HeyPCB/knuckle/cad/exploded.png

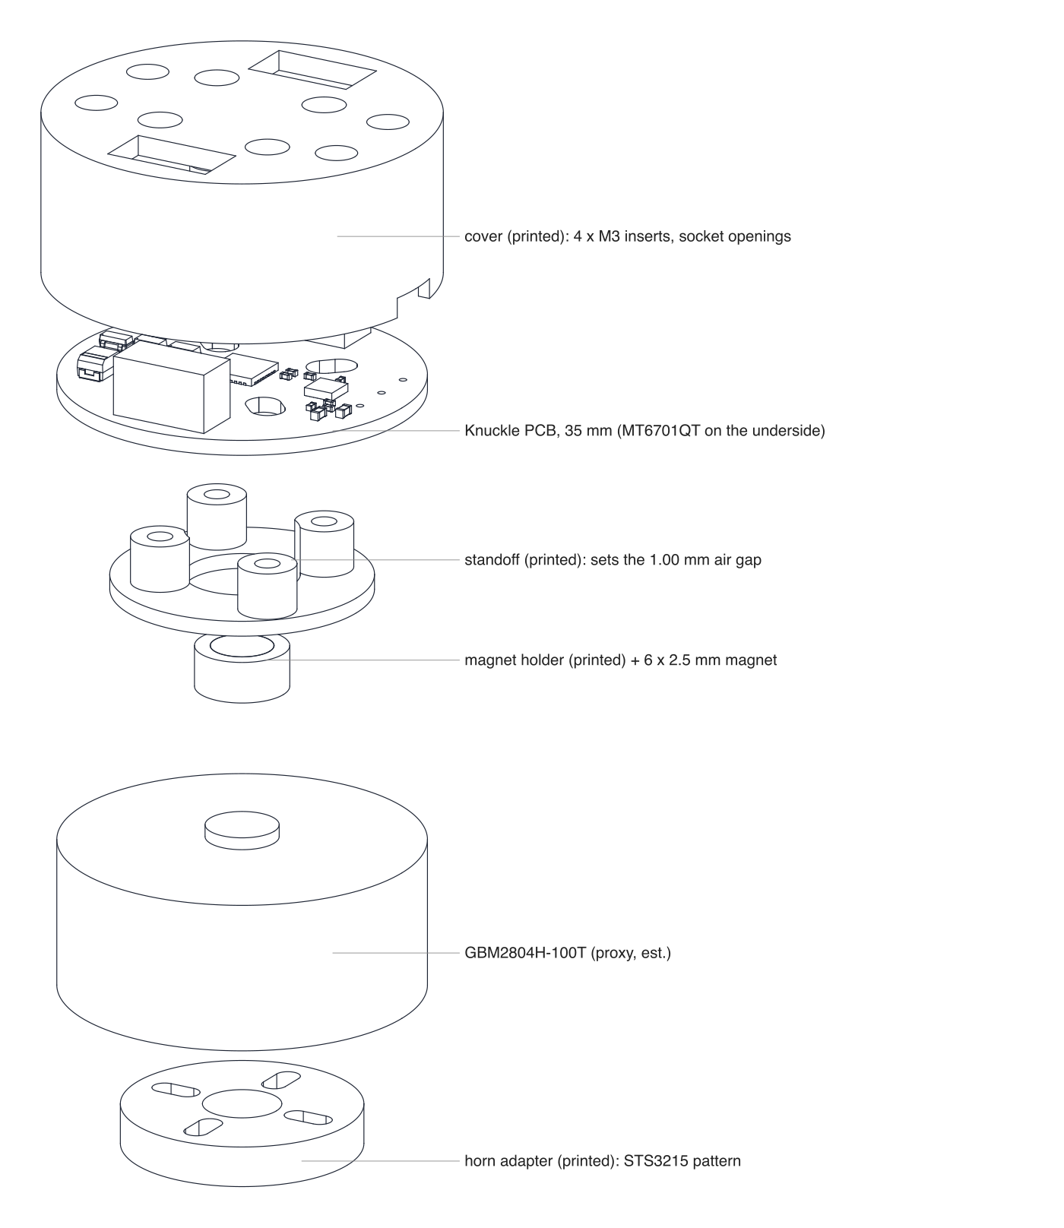
cad/exploded.png
