HeyPCB/knuckle/cad/section.png

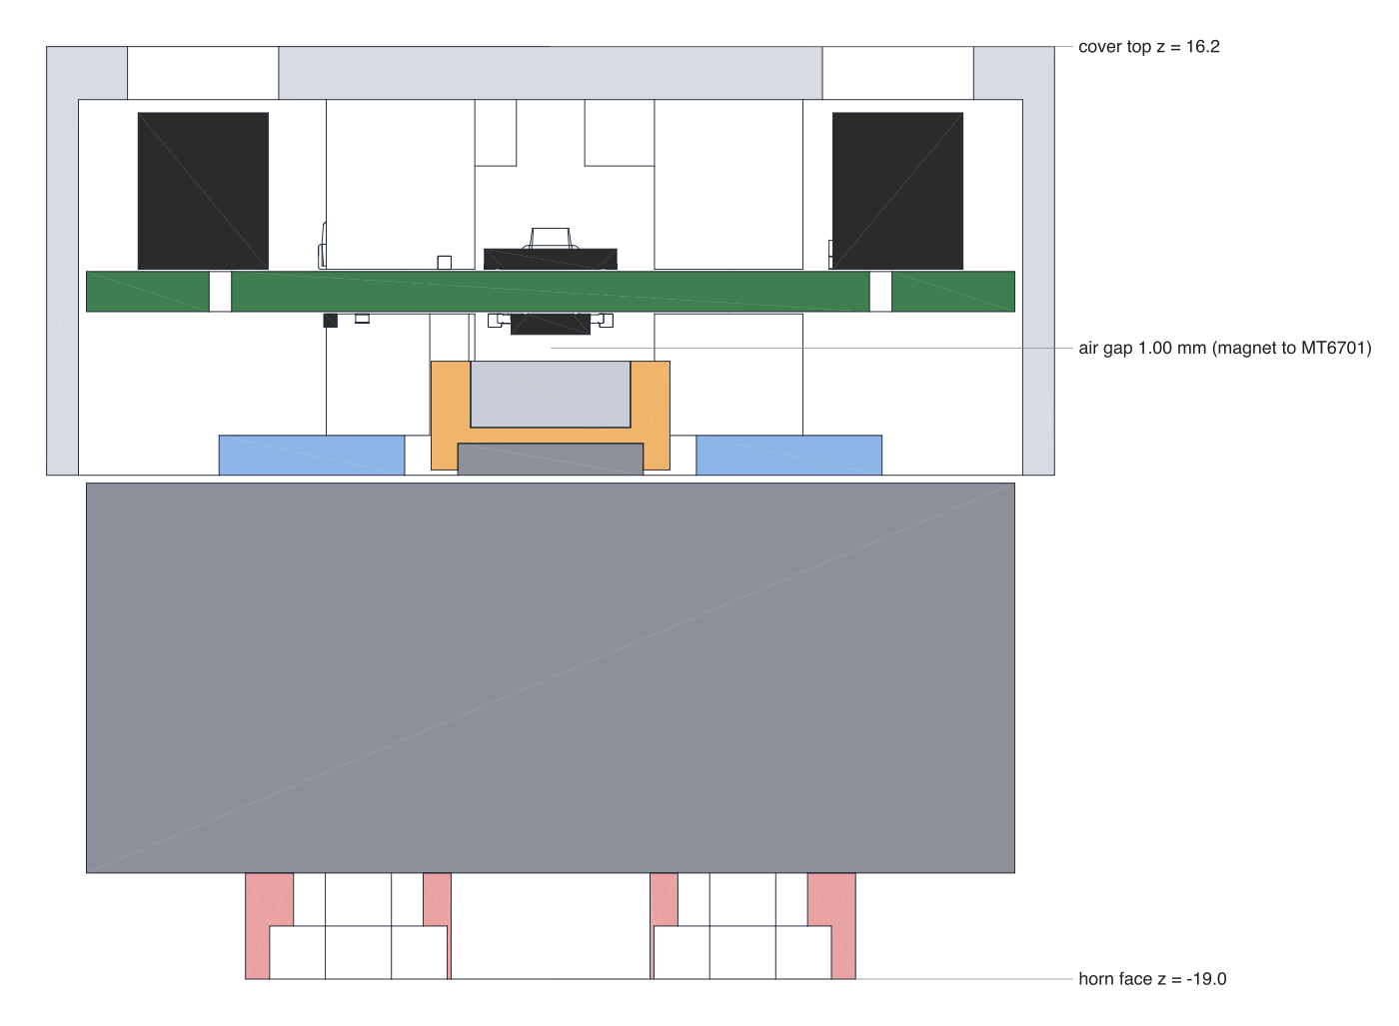
cad/section.png
