HeyPCB/knuckle/media/bottom.png

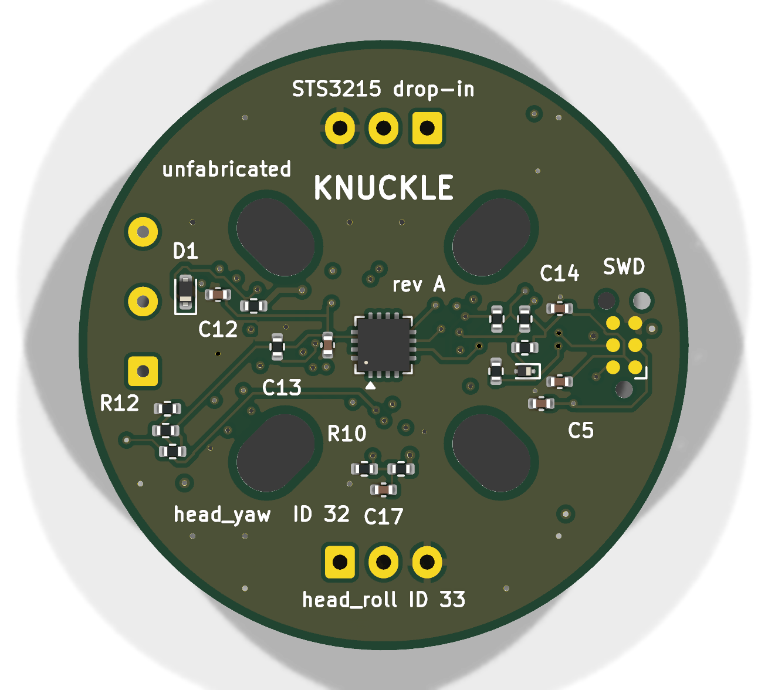
media/bottom.png
