HeyPCB/knuckle/media/top.png

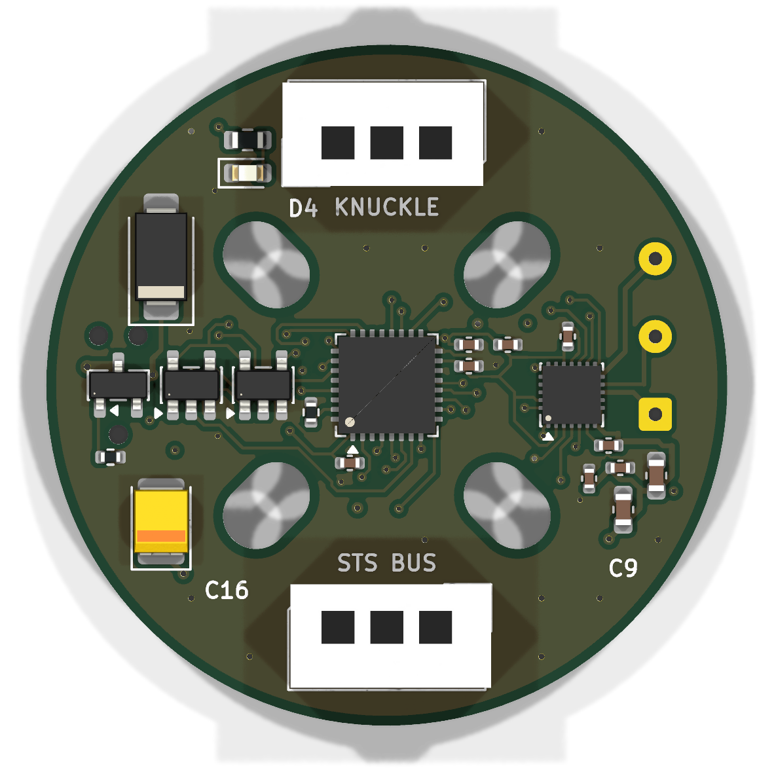
media/top.png
