HeyPCB/knuckle/fab/knuckle_bom.csv

Reference | Value | Footprint | MPN | LCSC | Qty
C1,C2,C3,C5,C10,C12,C13,C14,C15,C17 | 100nF | Capacitor_SMD:C_0402_1005Metric | CL05B104KO5NNNC | C1525 | 10
C4 | 1uF | Capacitor_SMD:C_0402_1005Metric | CL05A105KA5NQNC | C52923 | 1
C6,C8 | 100nF 50V | Capacitor_SMD:C_0402_1005Metric | CL05B104KB54PNC | C307331 | 2
C7,C9 | 10uF 25V | Capacitor_SMD:C_0603_1608Metric | CL10A106MA8NRNC | C96446 | 2
C11 | 2.2uF | Capacitor_SMD:C_0402_1005Metric | CL05A225MQ5NSNC | C12530 | 1
C16 | 22uF 25V polymer | Capacitor_Tantalum_SMD:CP_EIA-3528-21_Kemet-B | T521B226M025ATE100 | C696813 | 1
D1 | 5.1V | Diode_SMD:D_SOD-523 | MM5Z5V1T1G | C146754 | 1
D2 | ESD 5V | Diode_SMD:D_SOD-923 | TPESD9B5.0ST5G | C2682268 | 1
D3 | SMAJ12A | Diode_SMD:D_SMA | SMAJ12A | C113957 | 1
D4 | Red (STAT) | LED_SMD:LED_0603_1608Metric | KT-0603R | C2286 | 1
J1,J2 | 5267-03A | Connector_Molex:Molex_SPOX_5267-03A_1x03_P2.50mm_Vertical | 0022035035 | C45581067 | 2
Q1 | AO3401A | Package_TO_SOT_SMD:SOT-23 | AO3401A | C15127 | 1
R1,R6,R7,R9,R12 | 10k | Resistor_SMD:R_0402_1005Metric | 0402WGF1002TCE | C25744 | 5
R2,R4,R8,R10 | 100k | Resistor_SMD:R_0402_1005Metric | 0402WGF1003TCE | C25741 | 4
R3 | 5.1k | Resistor_SMD:R_0402_1005Metric | 0402WGF5101TCE | C25905 | 1
R5 | 100 | Resistor_SMD:R_0402_1005Metric | 0402WGF1000TCE | C25076 | 1
R11 | 22k | Resistor_SMD:R_0402_1005Metric | 0402WGF2202TCE | C25768 | 1
R13 | 1k | Resistor_SMD:R_0603_1608Metric | 0603WAF1001T5E | C21190 | 1
TH1 | 10k B3380 | Resistor_SMD:R_0402_1005Metric | NCP15XH103F03RC | C77131 | 1
U1 | STM32G431KBU6 | Package_DFN_QFN:QFN-32-1EP_5x5mm_P0.5mm_EP3.45x3.45mm | STM32G431KBU6 | C529358 | 1
U2 | DRV8311H | Package_DFN_QFN:Texas_RRW0024A_WQFN-24-1EP_3x3mm_P0.4mm_EP1.9x1.9mm | DRV8311HRRWR | C5218862 | 1
U3 | MT6701QT | Package_DFN_QFN:QFN-16-1EP_3x3mm_P0.5mm_EP1.7x1.7mm | MT6701QT-STD | C2913974 | 1
U4 | 74LVC1G126 | Package_TO_SOT_SMD:SOT-23-5 | SN74LVC1G126DBVR | C7834 | 1
U5 | 74LVC1G125 | Package_TO_SOT_SMD:SOT-23-5 | SN74LVC1G125DBVR | C23654 | 1
