HeyPCB/knuckle/cad/assembly.step

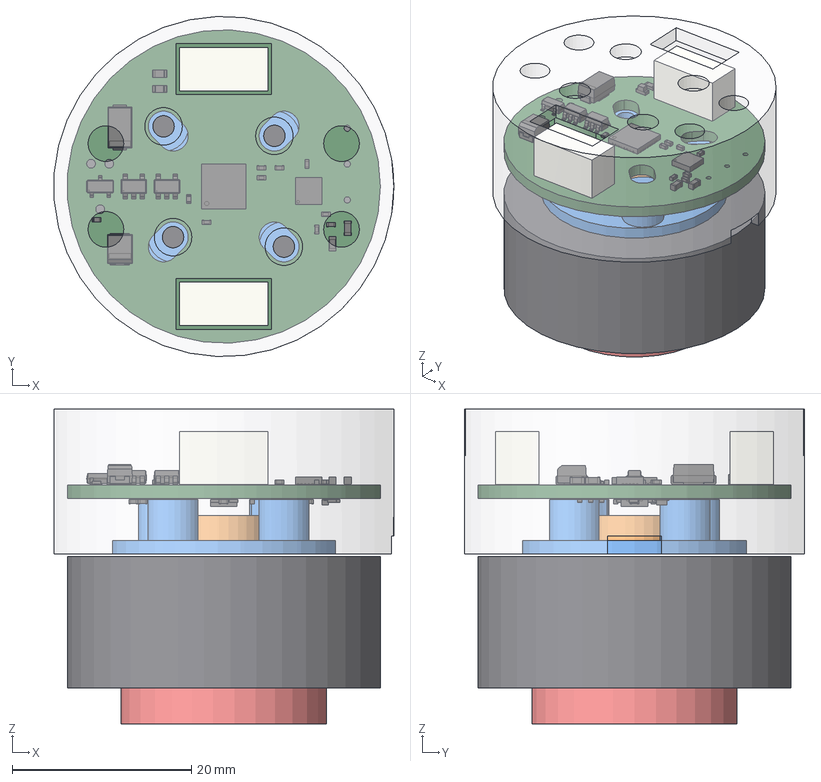
[picture p7: CAD file, 2026-10-03]
cad/assembly.step
37.9 x 38.0 x 35.2 mm
motor_proxy_est
magnet_holder
magnet
standoff
pcb
D3
D4
U5
R1
Q1
U2
R9
C11
C4
C16
C6
C1
C9
U1
C2
C10
R13
C8
U4
C3
C7
C5
R2
R10
D1
R3
R12
C12
C15
D2
R5
R4
C14
C13
R7
R6
R8
U3
C17
TH1
R11
J2_envelope
J1_envelope
cover
horn_adapter
