HeyPCB/knuckle/cad/magnet_holder.step

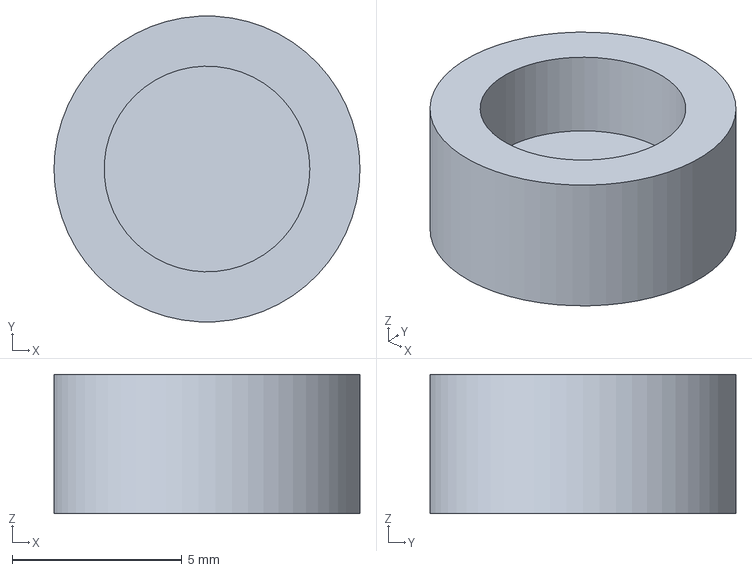
[picture p8: CAD file, 2026-10-03]
cad/magnet_holder.step
9.00 x 8.99 x 4.10 mm
