HeyPCB/knuckle/fab/knuckle.step

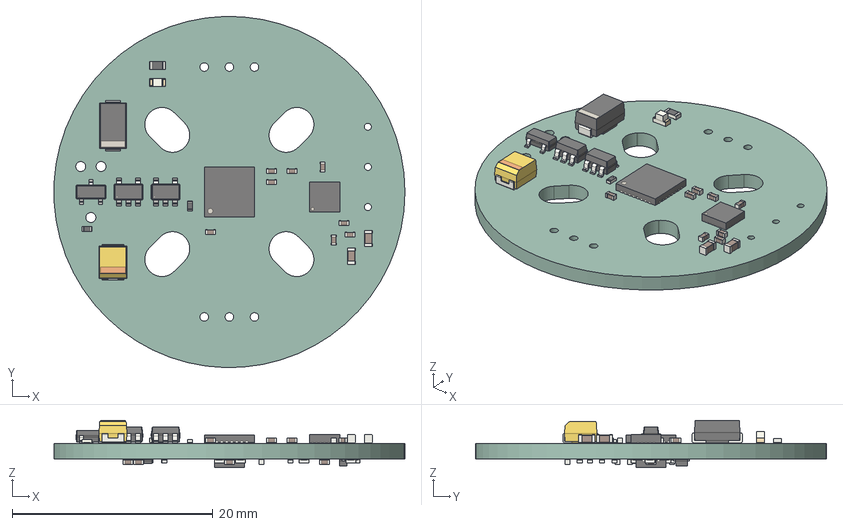
[picture p9: CAD file, 2026-10-03]
fab/knuckle.step
35.0 x 35.0 x 4.69 mm
D_SMA
LED_0603_1608Metric
SOT-23-5 x 2
R_0402_1005Metric x 13
SOT-23
Texas_RRW0024A_WQFN-24-1EP_3x3mm_P0.4mm_EP1.9x1.9mm
C_0402_1005Metric x 14
CP_EIA_3528_21_Kemet_B
C_0603_1608Metric x 2
QFN-32-1EP_5x5mm_Pitch0.5mm
R_0603_1608Metric
D_SOD_523
D_SOD_923
QFN-16-1EP_3x3mm_P0.5mm_EP1.7x1.7mm
knuckle_PCB
