HeyPCB/knuckle/cad/cover.step

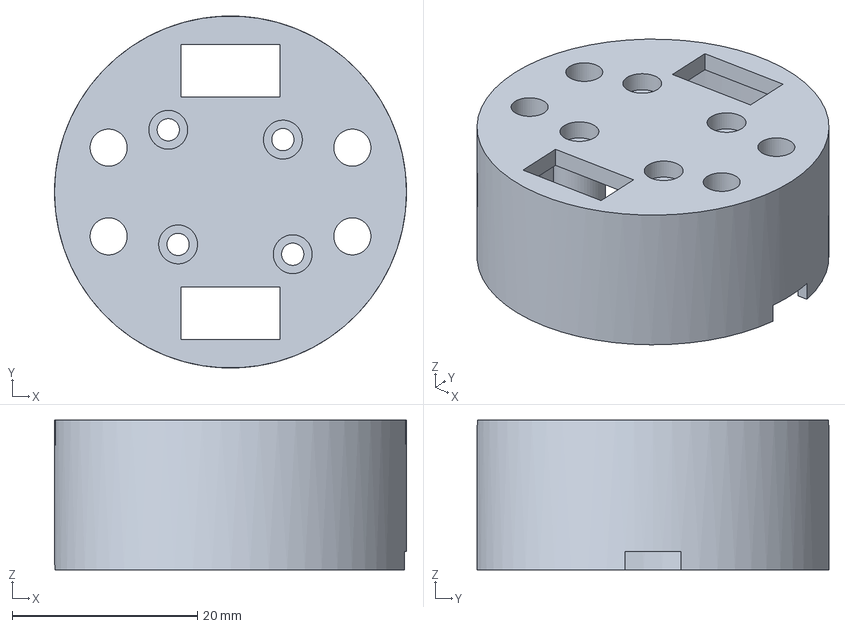
[picture p10: CAD file, 2026-10-03]
cad/cover.step
38.0 x 38.0 x 16.2 mm
