HeyPCB/knuckle/cad/standoff.step

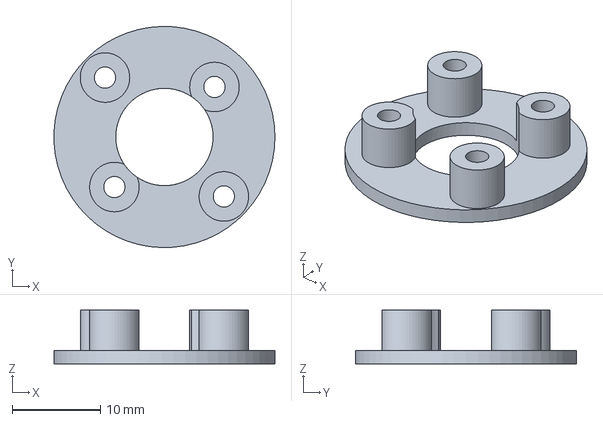
[picture p11: CAD file, 2026-10-03]
cad/standoff.step
25.0 x 25.0 x 6.09 mm
