HeyPCB/knuckle/cad/horn_adapter.step

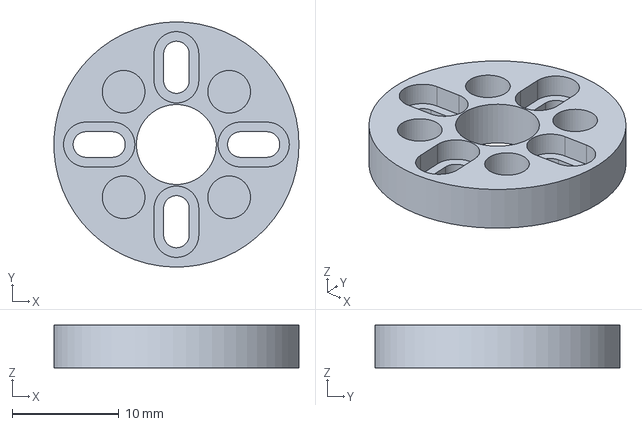
[picture p12: CAD file, 2026-10-03]
cad/horn_adapter.step
23.0 x 23.0 x 4.00 mm
