HeyPCB/knuckle/(list of files, cad)

Other CAD files:
cad/cover.stl
cad/horn_adapter.stl
cad/magnet_holder.stl
cad/standoff.stl
