HeyPCB/knuckle/fab/knuckle_schematic.pdf

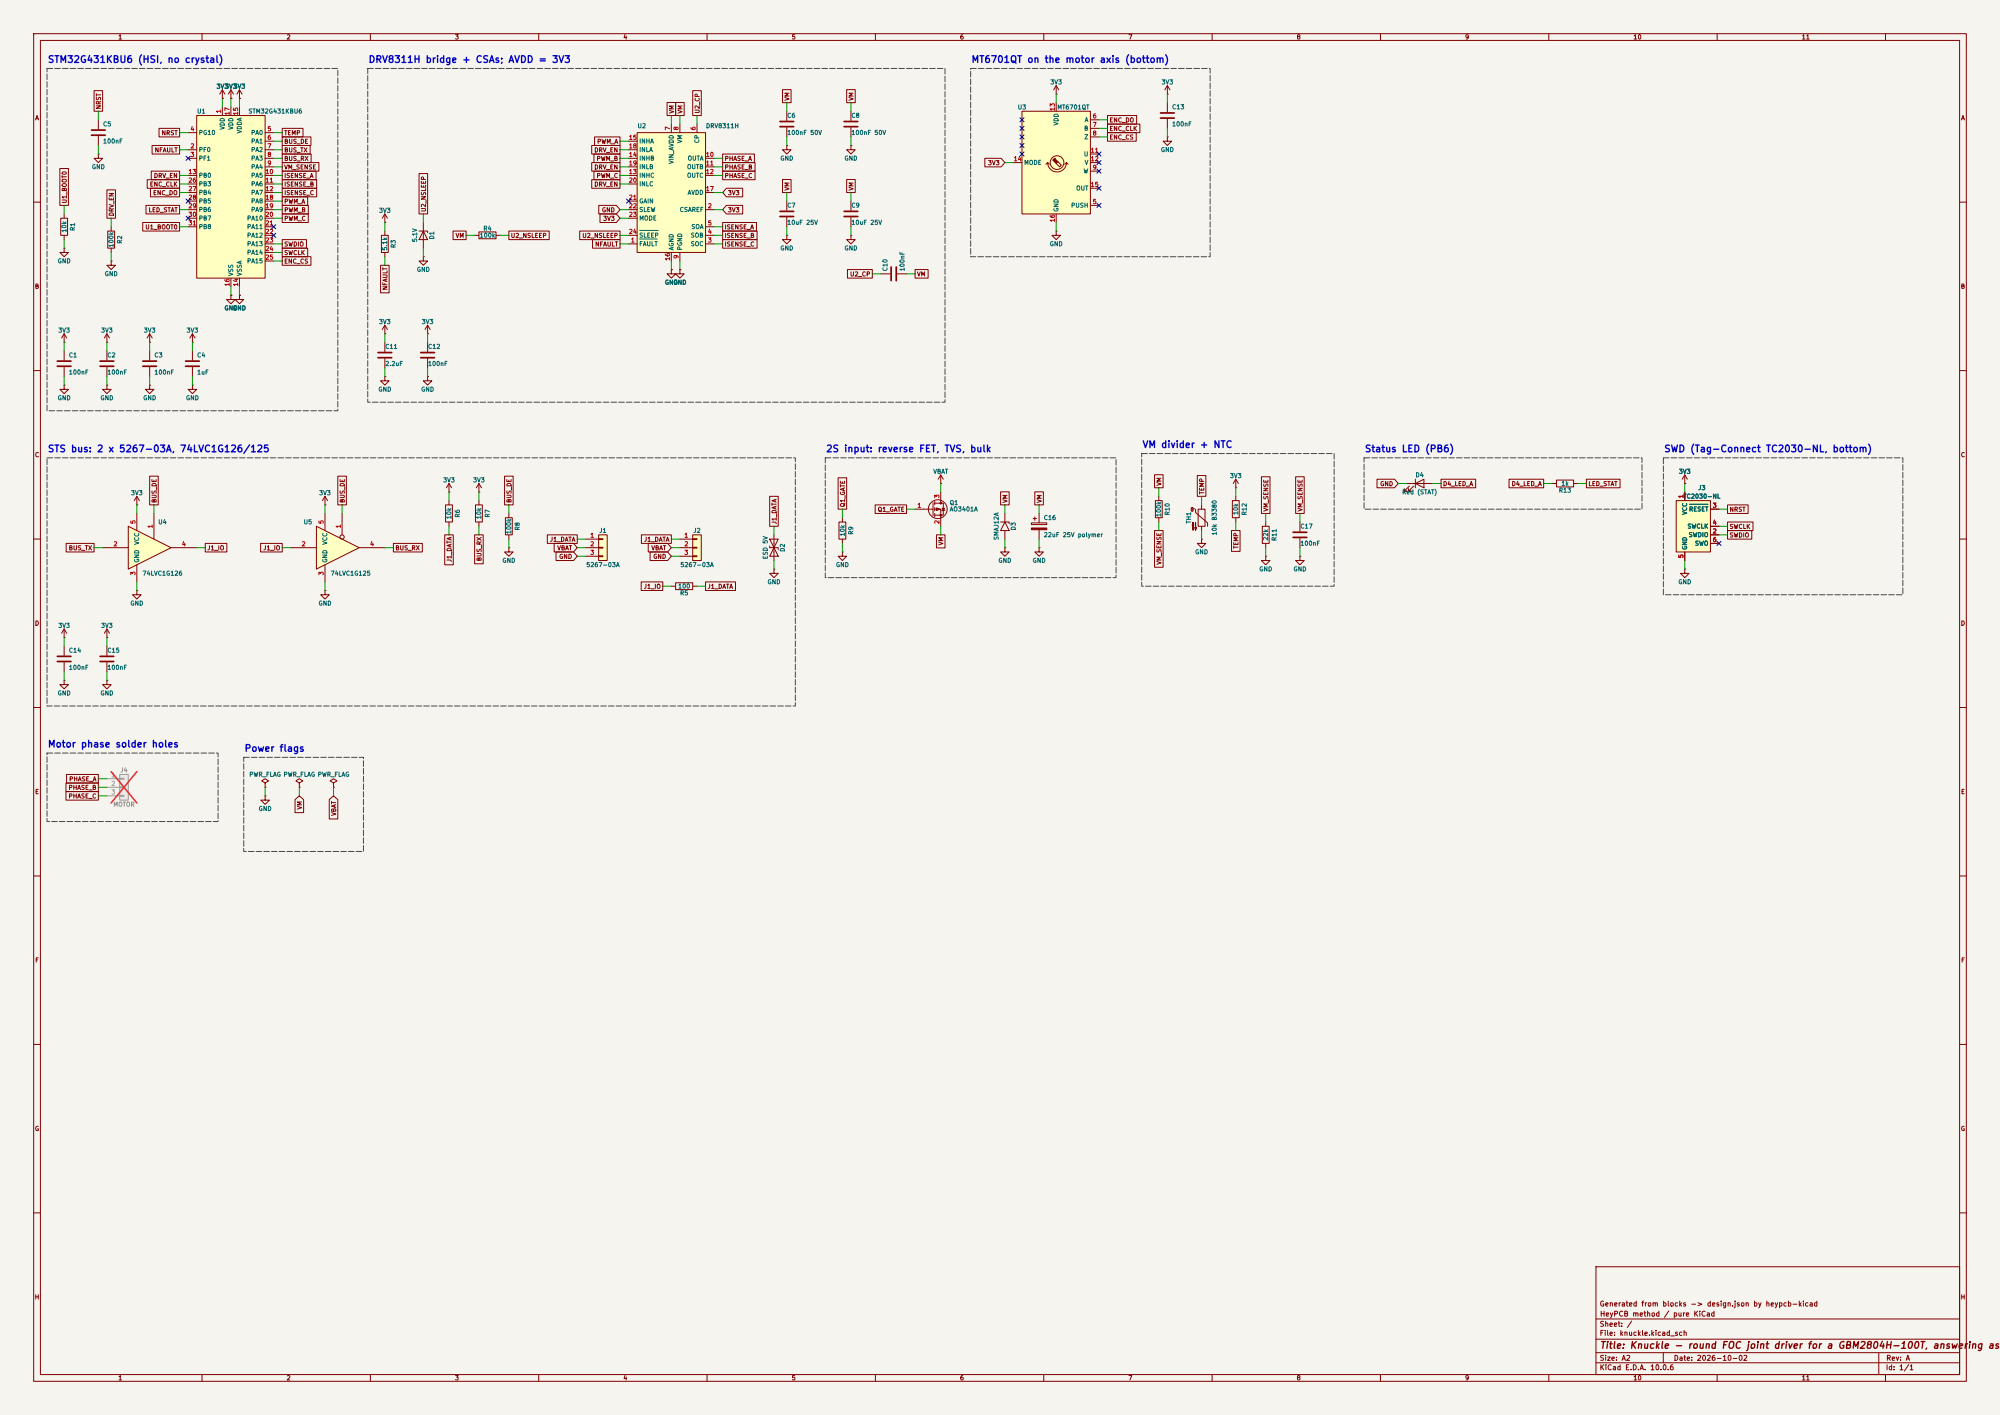
[picture p13: page 1]

1 PF0 2 PF1 3 PG10 4 PA0 5 PA1 6 PA2 7 PA3 8 PA4 9 PA5 10 PA6 11 PA7 12 PB0 13 VSSA 14 VDDA 15 VSS 16 VDD 17 PA8 18 PA9 19 PA10 20 PA11 21 PA12 22 PA13 23 PA14 24 PA15 25 PB3 26 PB4 27 PB5 28 PB6 29 PB7 30 PB8 31U1 STM32G431KBU6 C5

9 OUTA 10 OUTB 11 OUTC 12 INHC 13

Motor phase solder holes

HeyPCB method / pure KiCad
Sheet: /
File: knuckle.kicad_sch
Title: Knuckle - round FOC joint driver for a GBM2804H-100T, answering as an STS3215 on the Feetech bus

Size: A2 | Rev: A
KiCad E.D.A. 10.0.6 | Id: 1/1
