HeyPCB/knuckle/kicad/knuckle.kicad_pcb

## KiCad design kicad/knuckle.kicad_pcb (2026-10-03)

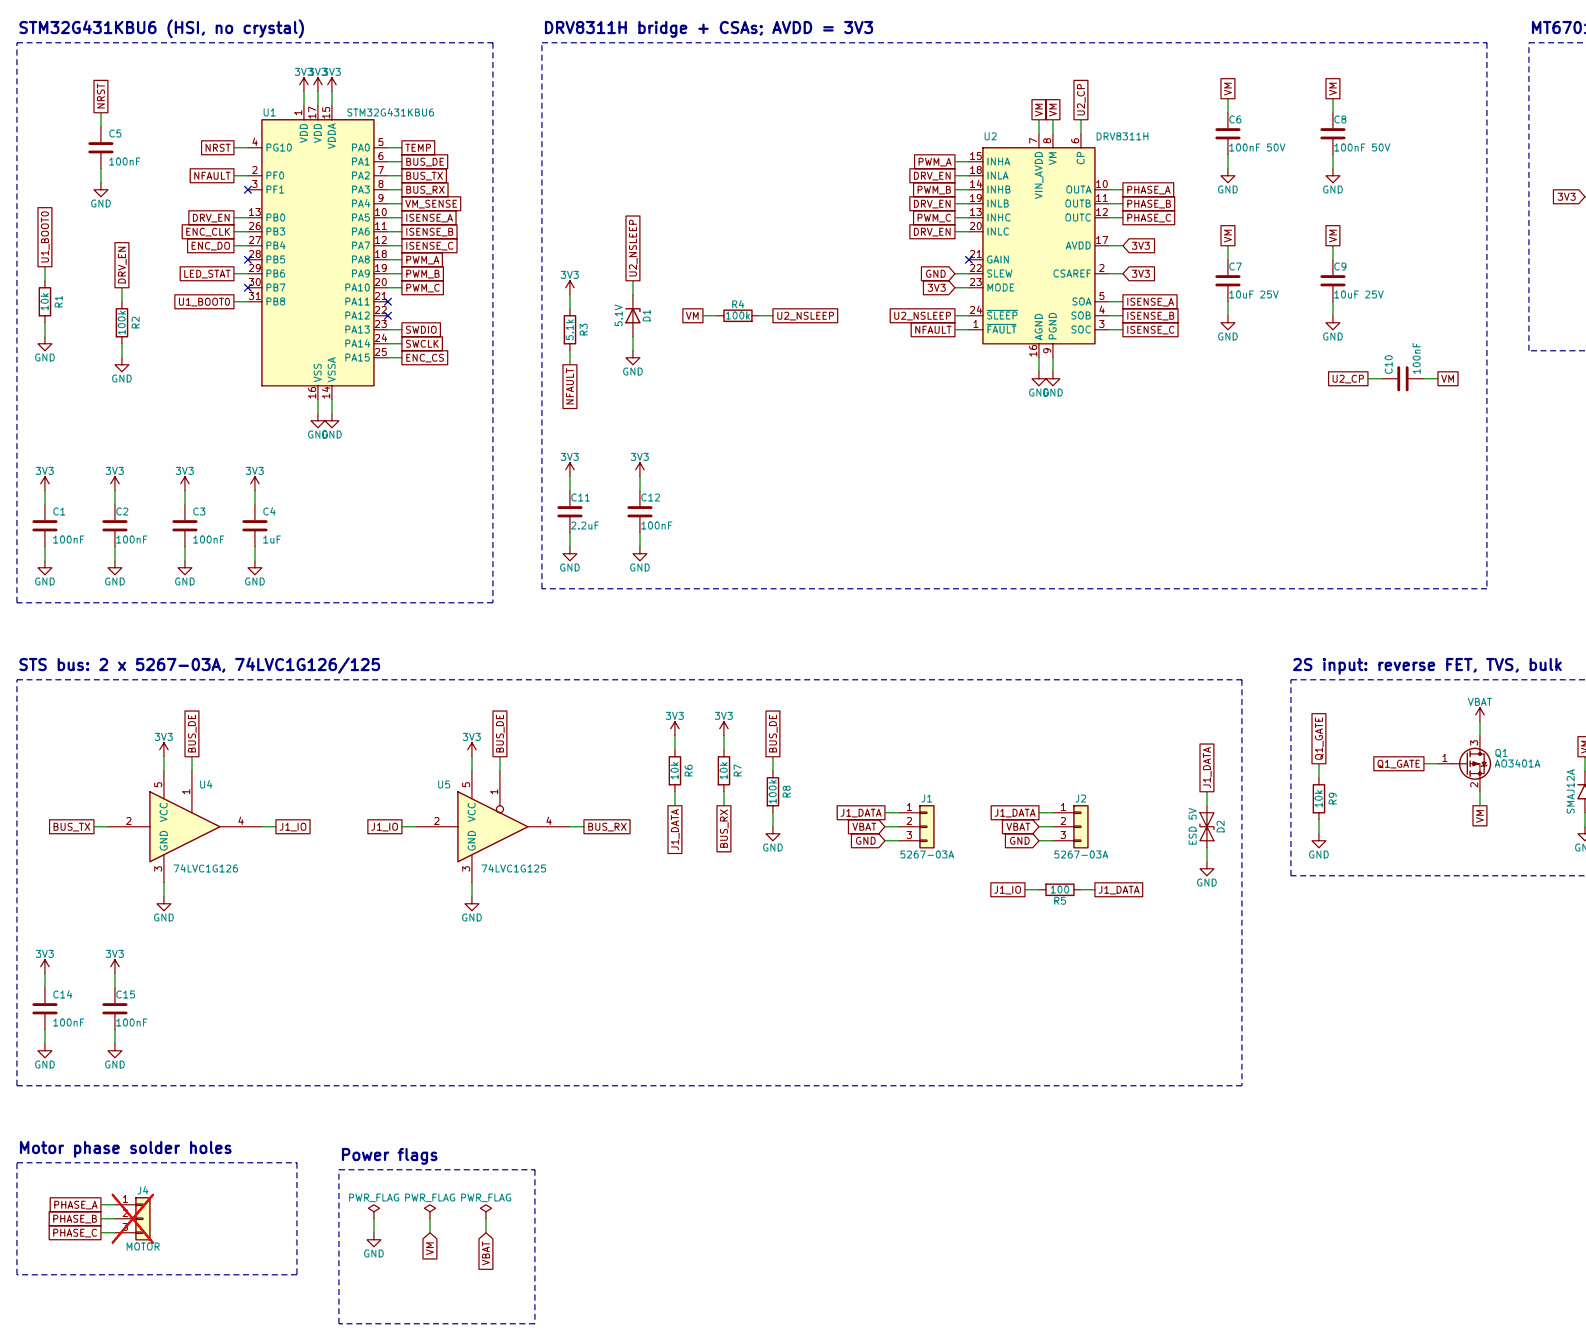
[picture p14: schematic knuckle.kicad_sch, Knuckle - round FOC joint driver for a GBM2804H-100T, answe…, part in row 1, column 1]

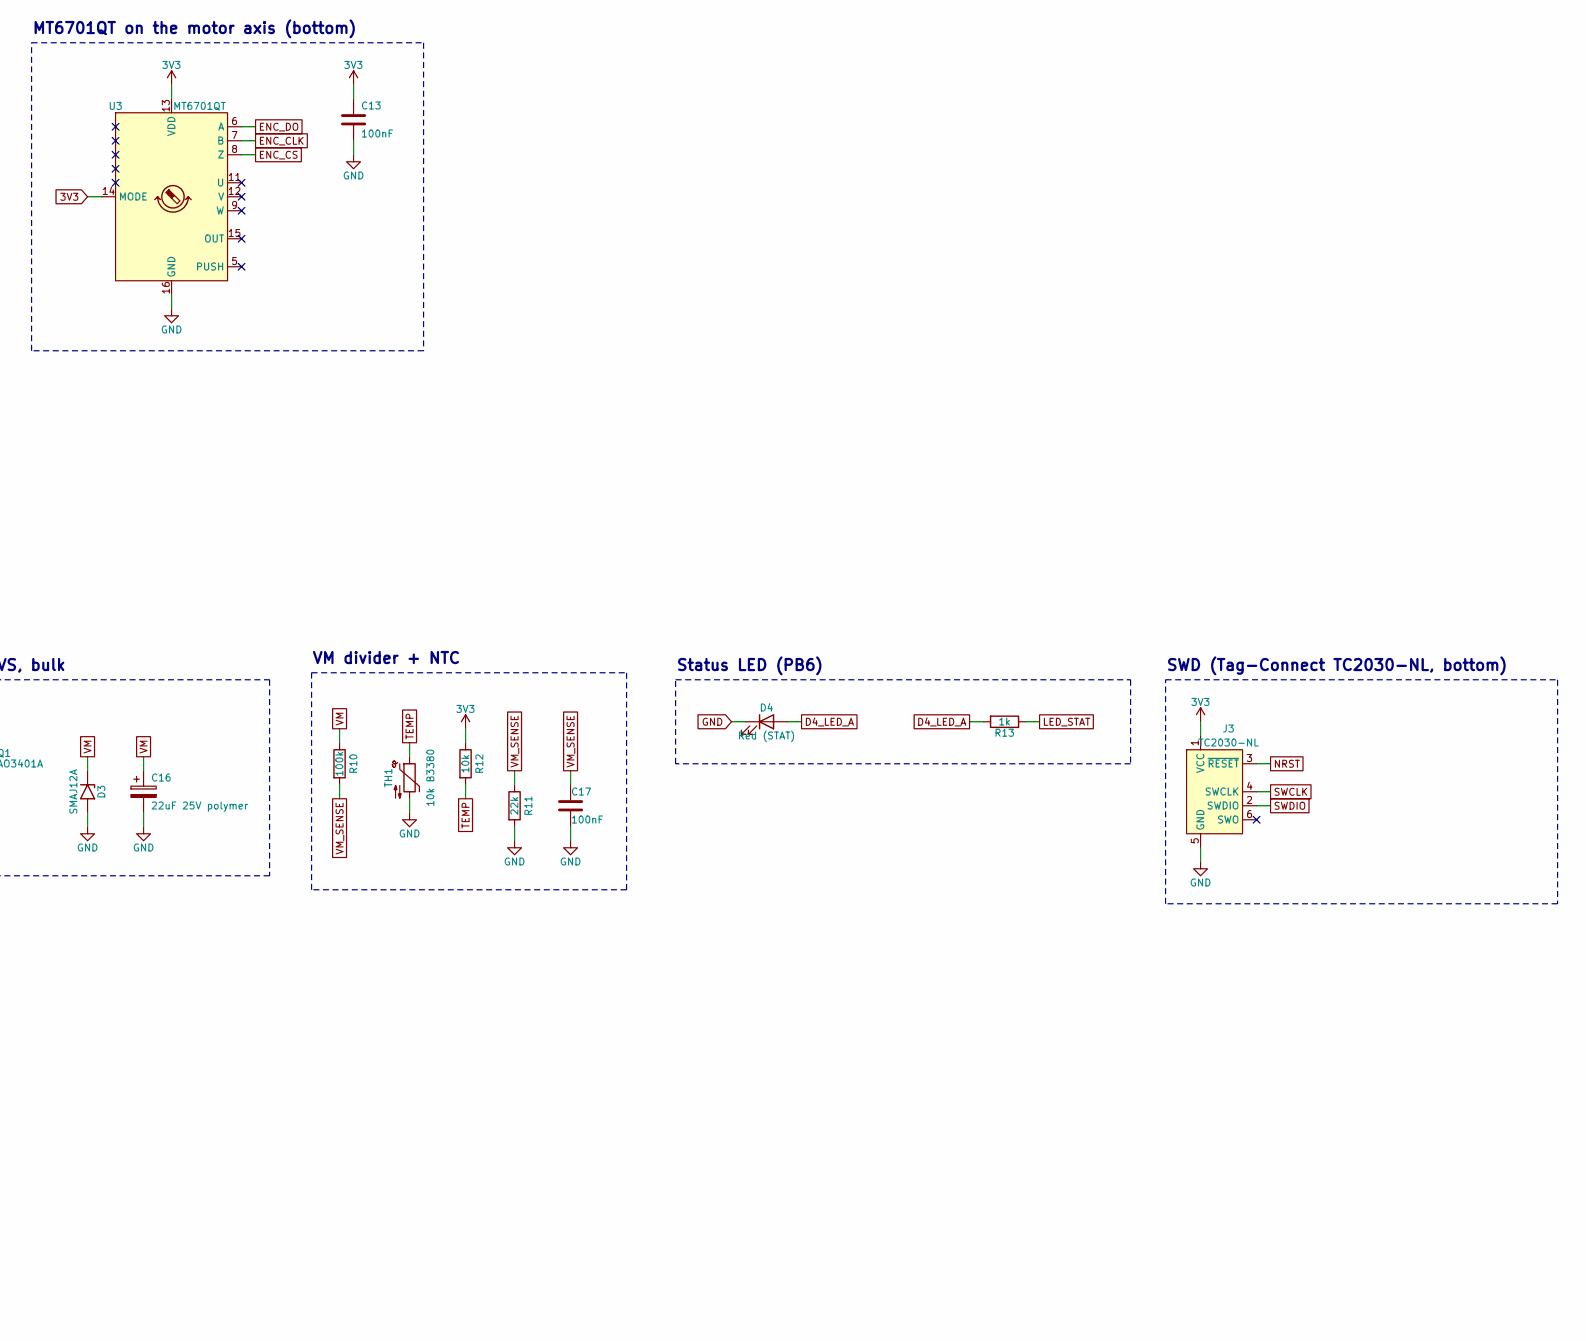
[picture p15: schematic knuckle.kicad_sch, Knuckle - round FOC joint driver for a GBM2804H-100T, answe…, part in row 1, column 2]

Parts:
C1, C2, C3, C5, C10, C12, C13, C14, C15, C17: 100nF; C_0402_1005Metric; MPN CL05B104KO5NNNC; LCSC C1525
C4: 1uF; C_0402_1005Metric; MPN CL05A105KA5NQNC; LCSC C52923
C6, C8: 100nF 50V; C_0402_1005Metric; MPN CL05B104KB54PNC; LCSC C307331
C7, C9: 10uF 25V; C_0603_1608Metric; MPN CL10A106MA8NRNC; LCSC C96446
C11: 2.2uF; C_0402_1005Metric; MPN CL05A225MQ5NSNC; LCSC C12530
C16: 22uF 25V polymer; CP_EIA-3528-21_Kemet-B; MPN T521B226M025ATE100; LCSC C696813
D1: 5.1V; D_SOD-523; MPN MM5Z5V1T1G; LCSC C146754
D2: ESD 5V; D_SOD-923; MPN TPESD9B5.0ST5G; LCSC C2682268
D3: SMAJ12A; D_SMA; MPN SMAJ12A; LCSC C113957
D4: Red (STAT); LED_0603_1608Metric; MPN KT-0603R; LCSC C2286
J1, J2: 5267-03A; Molex_SPOX_5267-03A_1x03_P2.50mm_Vertical; MPN 0022035035; LCSC C45581067
J3: TC2030-NL; Tag-Connect_TC2030-IDC-NL_2x03_P1.27mm_Vertical
J4: MOTOR; SolderWire-0.15sqmm_1x03_P4mm_D0.5mm_OD1.5mm; not fitted
Q1: AO3401A; SOT-23; MPN AO3401A; LCSC C15127
R1, R6, R7, R9, R12: 10k; R_0402_1005Metric; MPN 0402WGF1002TCE; LCSC C25744
R2, R4, R8, R10: 100k; R_0402_1005Metric; MPN 0402WGF1003TCE; LCSC C25741
R3: 5.1k; R_0402_1005Metric; MPN 0402WGF5101TCE; LCSC C25905
R5: 100; R_0402_1005Metric; MPN 0402WGF1000TCE; LCSC C25076
R11: 22k; R_0402_1005Metric; MPN 0402WGF2202TCE; LCSC C25768
R13: 1k; R_0603_1608Metric; MPN 0603WAF1001T5E; LCSC C21190
TH1: 10k B3380; R_0402_1005Metric; MPN NCP15XH103F03RC; LCSC C77131
U1: STM32G431KBU6; QFN-32-1EP_5x5mm_P0.5mm_EP3.45x3.45mm; MPN STM32G431KBU6; LCSC C529358
U2: DRV8311H; Texas_RRW0024A_WQFN-24-1EP_3x3mm_P0.4mm_EP1.9x1.9mm; MPN DRV8311HRRWR; LCSC C5218862
U3: MT6701QT; QFN-16-1EP_3x3mm_P0.5mm_EP1.7x1.7mm; MPN MT6701QT-STD; LCSC C2913974
U4: 74LVC1G126; SOT-23-5; MPN SN74LVC1G126DBVR; LCSC C7834
U5: 74LVC1G125; SOT-23-5; MPN SN74LVC1G125DBVR; LCSC C23654

Connections:
3V3: C1.1, C2.1, C3.1, C4.1, C11.1, C12.1, C13.1, C14.1, C15.1, J3.1 (VCC), R3.1, R6.1, R7.1, R12.1, U1.1 (VDD), U1.15 (VDDA), U1.17 (VDD), U2.2 (CSAREF), U2.17 (AVDD), U2.23 (MODE), U3.13 (VDD), U3.14 (MODE), U4.5 (VCC), U5.5 (VCC)
BUS_DE: R8.1, U1.6 (PA1), U4.1, U5.1
BUS_RX: R7.2, U1.8 (PA3), U5.4
BUS_TX: U1.7 (PA2), U4.2
D4_LED_A: D4.2 (A), R13.2
DRV_EN: R2.1, U1.13 (PB0), U2.18 (INLA), U2.19 (INLB), U2.20 (INLC)
ENC_CLK: U1.26 (PB3), U3.7 (B)
ENC_CS: U1.25 (PA15), U3.8 (Z)
ENC_DO: U1.27 (PB4), U3.6 (A)
GND: C1.2, C2.2, C3.2, C4.2, C5.2, C6.2, C7.2, C8.2, C9.2, C11.2, C12.2, C13.2, C14.2, C15.2, C16.2, C17.2, D1.2 (A), D2.2 (A2), D3.2 (A2), D4.1 (K), J1.3, J2.3, J3.5 (GND), R1.2, R2.2, R8.2, R9.2, R11.2, TH1.2, U1.14 (VSSA), U1.16 (VSS), U1.32 (VSS), U1.33 (VSS), U2.9 (PGND), U2.16 (AGND), U2.22 (SLEW), U2.25 (PGND), U3.16 (GND), U3.17 (GND), U4.3 (GND), U5.3 (GND)
ISENSE_A: U1.10 (PA5), U2.5 (SOA)
ISENSE_B: U1.11 (PA6), U2.4 (SOB)
ISENSE_C: U1.12 (PA7), U2.3 (SOC)
J1_DATA: D2.1 (A1), J1.1, J2.1, R5.1, R6.2
J1_IO: R5.2, U4.4, U5.2
LED_STAT: R13.1, U1.29 (PB6)
NFAULT: R3.2, U1.2 (PF0), U2.1 (~FAULT)
NRST: C5.1, J3.3 (~RESET), U1.4 (PG10)
PHASE_A: J4.1, U2.10 (OUTA)
PHASE_B: J4.2, U2.11 (OUTB)
PHASE_C: J4.3, U2.12 (OUTC)
PWM_A: U1.18 (PA8), U2.15 (INHA)
PWM_B: U1.19 (PA9), U2.14 (INHB)
PWM_C: U1.20 (PA10), U2.13 (INHC)
Q1_GATE: Q1.1 (G), R9.1
SWCLK: J3.4 (SWCLK), U1.24 (PA14)
SWDIO: J3.2 (SWDIO), U1.23 (PA13)
TEMP: R12.2, TH1.1, U1.5 (PA0)
U1_BOOT0: R1.1, U1.31 (PB8)
U2_CP: C10.1, U2.6 (CP)
U2_NSLEEP: D1.1 (K), R4.2, U2.24 (~SLEEP)
VBAT: J1.2, J2.2, Q1.3 (D)
VM: C6.1, C7.1, C8.1, C9.1, C10.2, C16.1, D3.1 (A1), Q1.2 (S), R4.1, R10.1, U2.7 (VIN_AVDD), U2.8 (VM)
VM_SENSE: C17.1, R10.2, R11.1, U1.9 (PA4)

Notes on the sheet:
STM32G431KBU6 (HSI, no crystal)
DRV8311H bridge + CSAs; AVDD = 3V3
MT6701QT on the motor axis (bottom)
STS bus: 2 x 5267-03A, 74LVC1G126/125
2S input: reverse FET, TVS, bulk
VM divider + NTC
Status LED (PB6)
SWD (Tag-Connect TC2030-NL, bottom)
Motor phase solder holes
Power flags

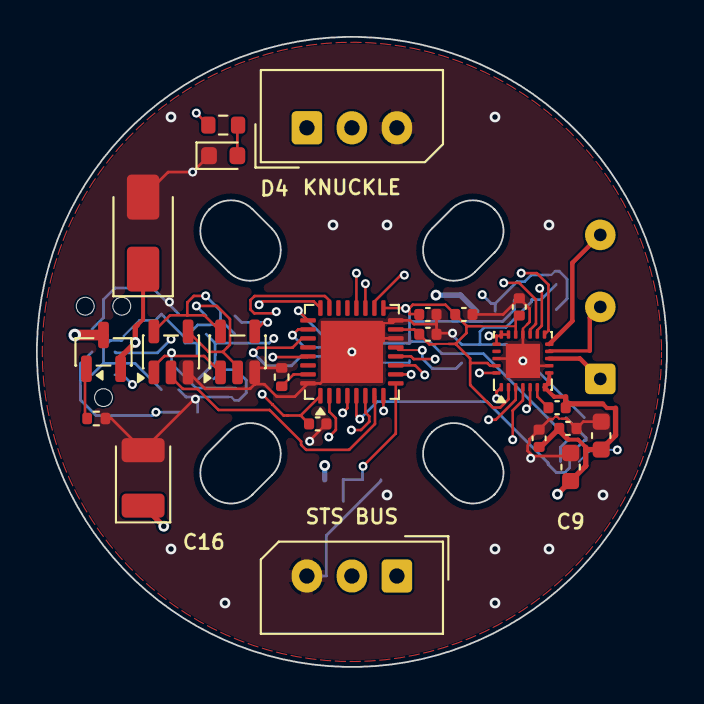
[picture p16: board knuckle.kicad_pcb from above]

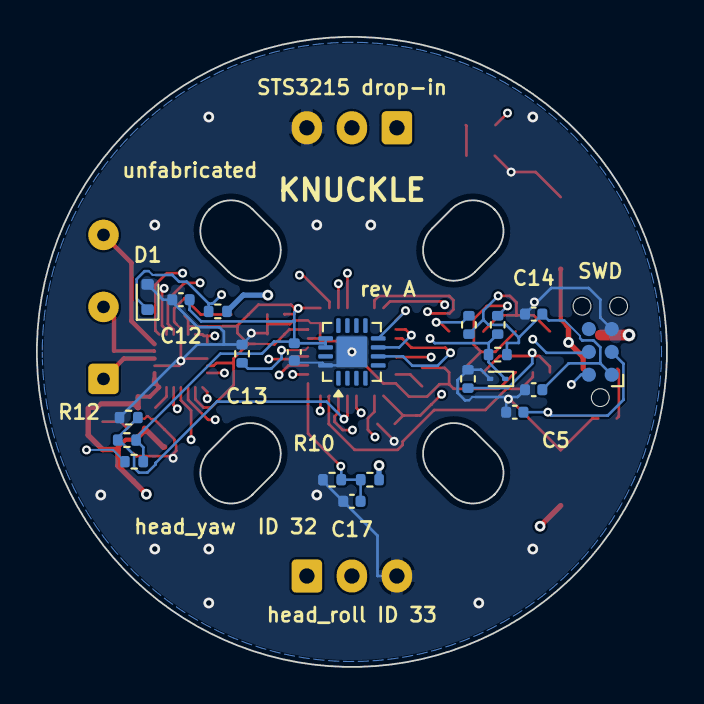
[picture p17: board knuckle.kicad_pcb from below]

Board: 6 copper layers, 35.0 x 35.0 mm, 45 parts (21 on the bottom side), 34 nets.
